ralf-e/HeishaMon/touch-extension/manufacturing/JLCPCB/Rev07/drill_report.txt

Drill report for HeishaMon_V6_Touch_Adapter.kicad_pcb
Created on 2026-10-30T16:30:36

Copper Layer Stackup:
    =============================================================
    L1 :  F.Cu                      front
    L2 :  B.Cu                      back

Drill file 'HeishaMon_V6_Touch_Adapter-PTH.drl' contains
    plated through holes:
    =============================================================
    T1  0.200mm  0.0079"  (79 holes))
    T2  0.700mm  0.0276"  (2 holes))
    T3  1.000mm  0.0394"  (20 holes))

    Total plated holes count 101

Drill file 'HeishaMon_V6_Touch_Adapter-NPTH.drl' contains
    unplated through holes:
    =============================================================

    Total unplated holes count 0
