ralf-e/HeishaMon/touch-extension/docs/adapter_spi.png

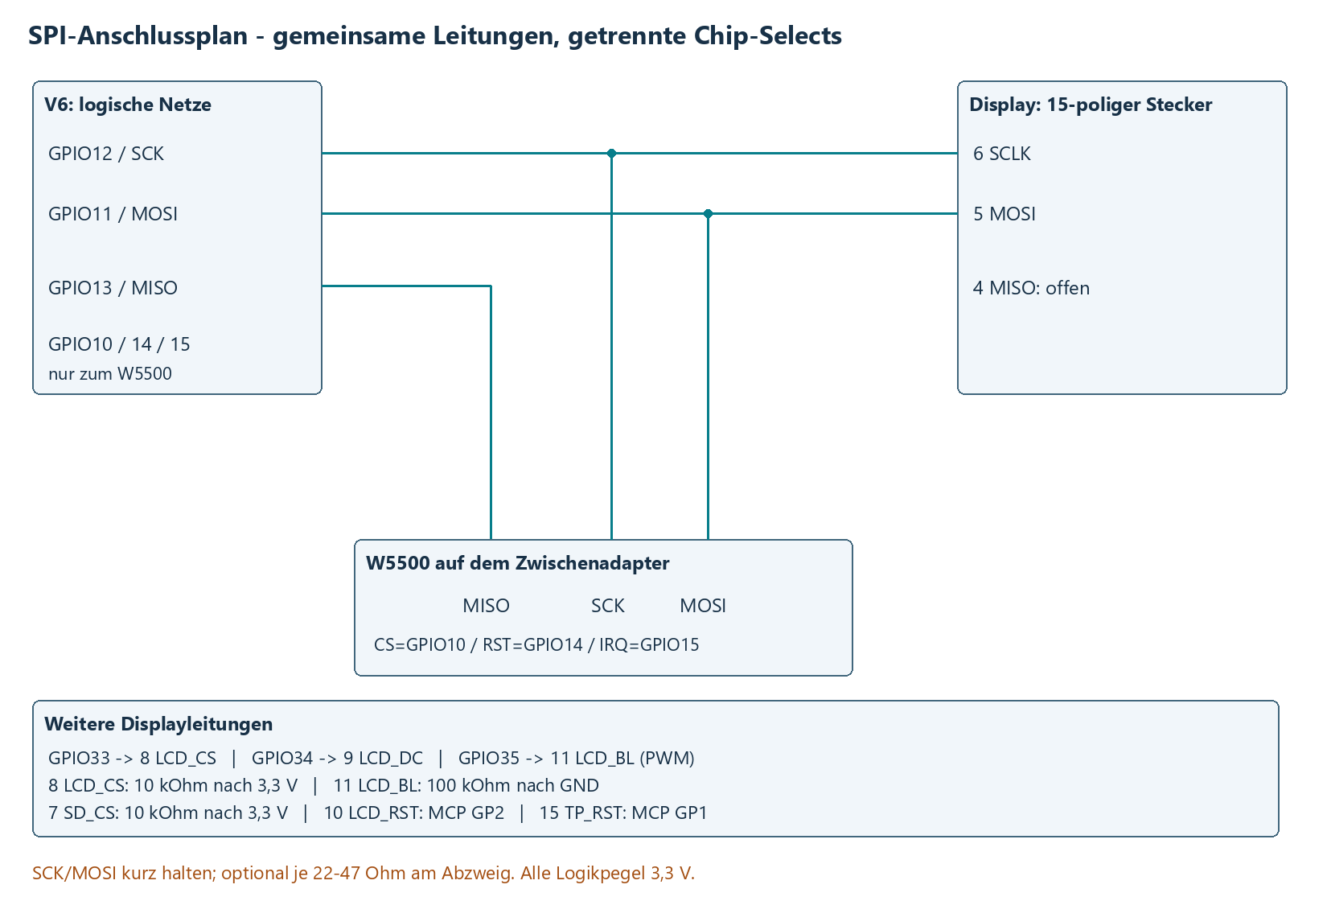
touch-extension/docs/adapter_spi.png
