ralf-e/HeishaMon/touch-extension/docs/display_topics.png

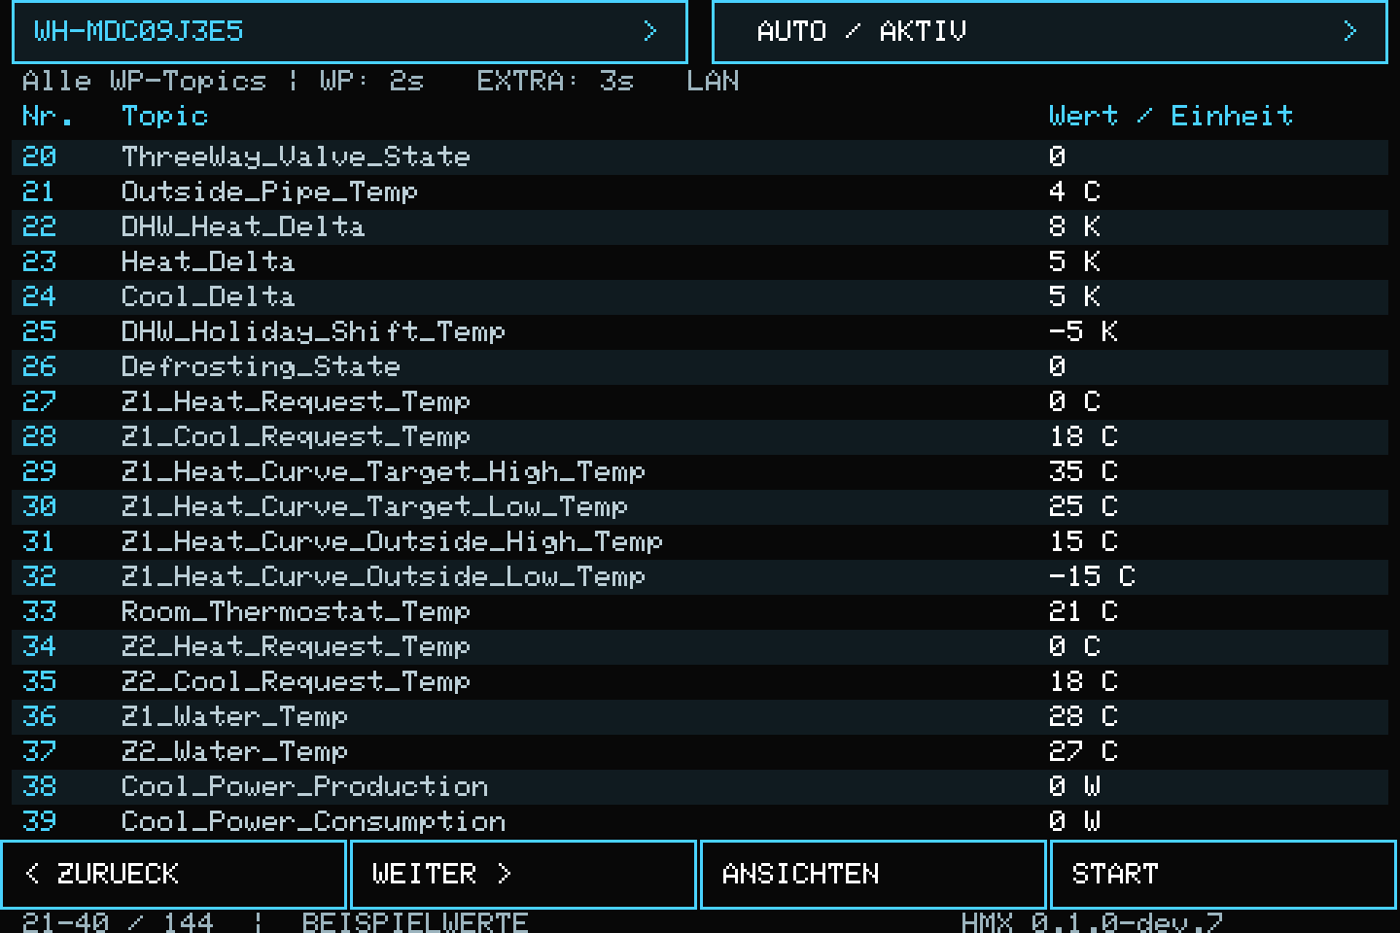
touch-extension/docs/display_topics.png
