ralf-e/HeishaMon/touch-extension/docs/PCB_Rueckseite.png

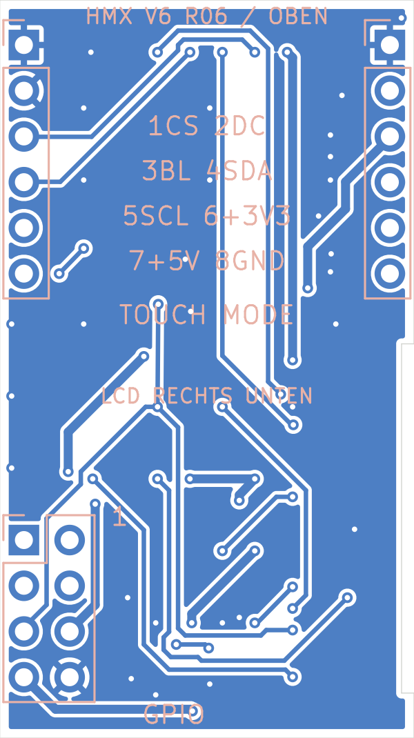
touch-extension/docs/PCB_Rueckseite.png
