ralf-e/HeishaMon/touch-extension/docs/PCB_Vorderseite.png

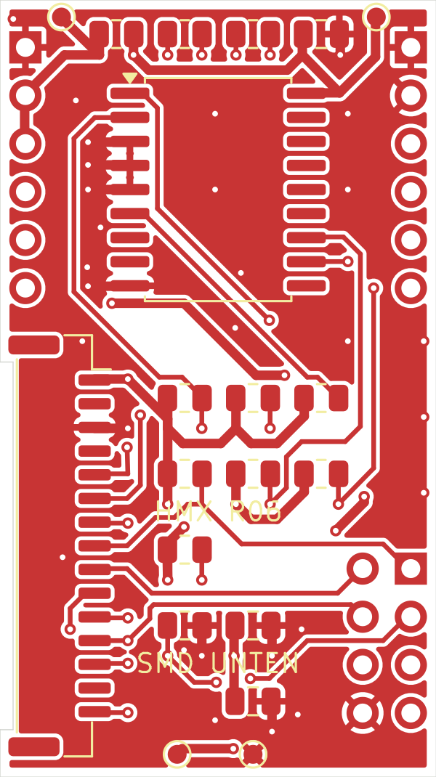
touch-extension/docs/PCB_Vorderseite.png
