ralf-e/HeishaMon/touch-extension/hardware/Rev07/Bestueckung_F.png

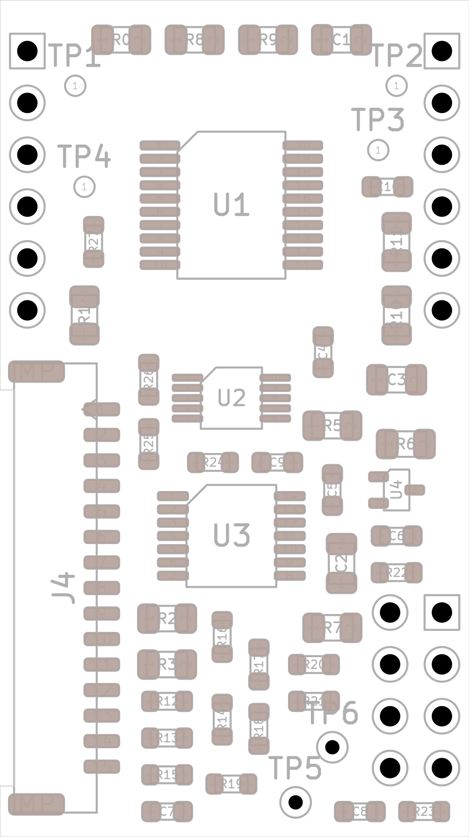
touch-extension/hardware/Rev07/Bestueckung_F.png
