ralf-e/HeishaMon/touch-extension/hardware/Rev07/Bestueckungsrotationen.png

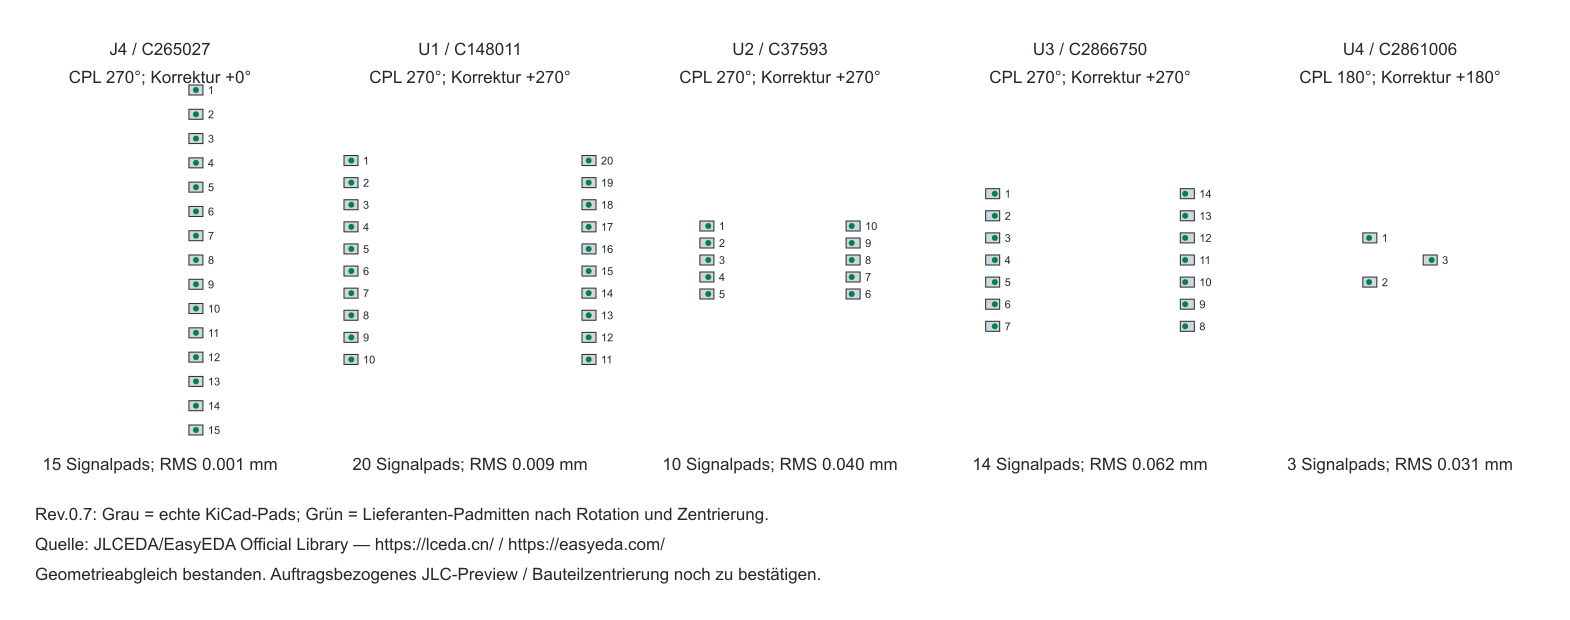
touch-extension/hardware/Rev07/Bestueckungsrotationen.png
