ralf-e/HeishaMon/touch-extension/hardware/Rev07/PCB_3D_Pruefansicht.png

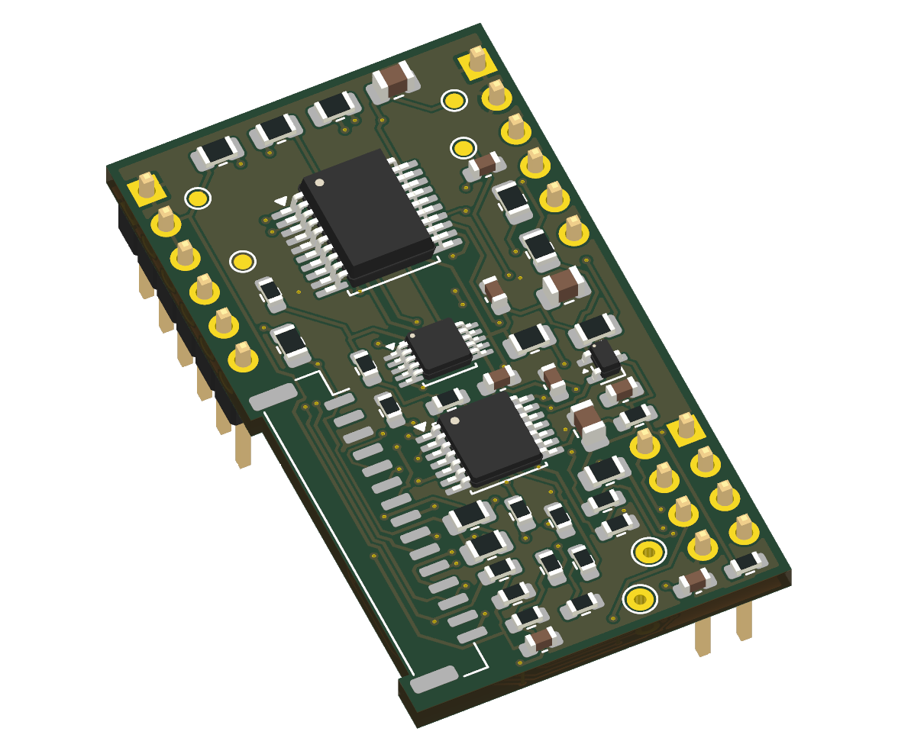
touch-extension/hardware/Rev07/PCB_3D_Pruefansicht.png
