ralf-e/HeishaMon/touch-extension/hardware/Rev07/PCB_Rueckseite.png

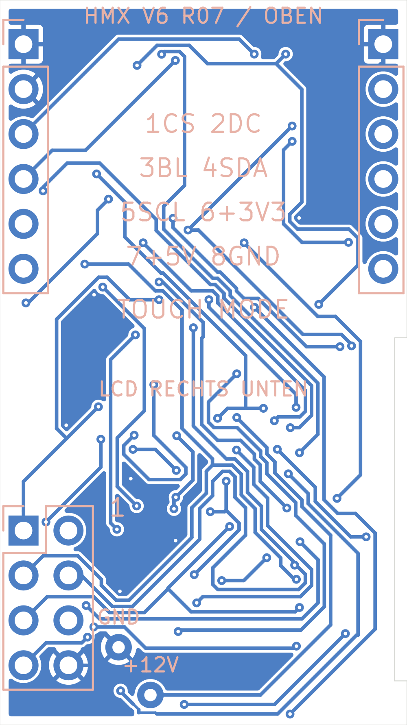
touch-extension/hardware/Rev07/PCB_Rueckseite.png
