ralf-e/HeishaMon/touch-extension/hardware/Rev07/PCB_Vorderseite.png

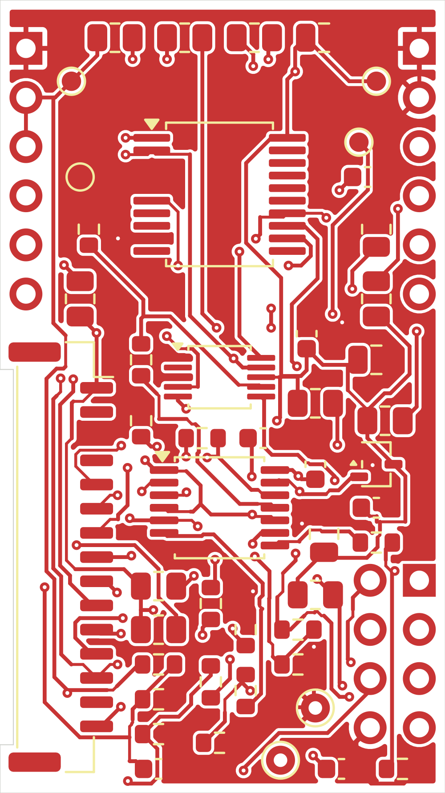
touch-extension/hardware/Rev07/PCB_Vorderseite.png
