ralf-e/HeishaMon/touch-extension/manufacturing/JLCPCB/Rev07/BOM_JLCPCB_REVIEW.csv

Comment | Designator | Footprint | LCSC Part #
0R | R0 | R_0805_2012Metric | C17477
4.7k 1% | R1,R2 | R_0805_2012Metric | C17673
10k 1% | R3,R5,R6,R7,R10 | R_0805_2012Metric | C17414
33R 1% | R8,R9 | R_0805_2012Metric | C17634
100k 1% | R11 | R_0805_2012Metric | C149504
100nF 50V X7R 10% | C1,C2 | C_0805_2012Metric | C49678
10uF 25V X5R 10% | C3 | C_0805_2012Metric | C15850
JST GH 15P 1.25mm Side Entry 90deg | J4 | JST_GH_SM15B-GHS-TB_1x15-1MP_P1.25mm_Horizontal | C265027
MCP23008 SSOP20 | U1 | SSOP-20_5.3x7.2mm_P0.65mm | C148011
ADS1115 VSSOP10 | U2 | TSSOP-10_3x3mm_P0.5mm | C37593
TMUX1511 TSSOP14 | U3 | TSSOP-14_4.4x5mm_P0.65mm | C2866750
2.93V supervisor SC70 | U4 | SOT-323_SC-70 | C2861006
10k 0.1% | R12,R13,R16,R17,R21,R25 | R_0603_1608Metric | C95204
20k 0.1% | R20 | R_0603_1608Metric | C723637
68k 0.1% | R24 | R_0603_1608Metric | C705793
1k 0.1% | R14,R18,R22,R26 | R_0603_1608Metric | C110776
100k 0.1% | R15,R19,R23,R27 | R_0603_1608Metric | C122538
100n X7R 50V 10% | C4,C5,C6,C7,C8,C9,C10 | C_0603_1608Metric | C1591
