ralf-e/HeishaMon/touch-extension/hardware/Rev07/V6_Kontaktpruefung.csv

Stecker | Pin | Sollnetz aus Entwurf | Referenz X montiert mm | Referenz Y montiert mm | Istnetz am V6 | Messwert/Abstand | Ergebnis
J1 | 1 | GND | 100.000 | 100.000 |  |  | OFFEN
J1 | 2 | GND | 100.000 | 102.540 |  |  | OFFEN
J1 | 3 | SPI_MOSI | 100.000 | 105.080 |  |  | OFFEN
J1 | 4 | SPI_SCK | 100.000 | 107.620 |  |  | OFFEN
J1 | 5 | ETH_CS | 100.000 | 110.160 |  |  | OFFEN
J1 | 6 | ETH_IRQ | 100.000 | 112.700 |  |  | OFFEN
J2 | 1 | GND | 120.320 | 100.000 |  |  | OFFEN
J2 | 2 | +3V3_V6 | 120.320 | 102.540 |  |  | OFFEN
J2 | 3 | +3V3_V6 | 120.320 | 105.080 |  |  | OFFEN
J2 | 4 | NC | 120.320 | 107.620 |  |  | OFFEN
J2 | 5 | ETH_RST | 120.320 | 110.160 |  |  | OFFEN
J2 | 6 | SPI_MISO | 120.320 | 112.700 |  |  | OFFEN
J3 | 1 | LCD_CS | 100.000 | 127.500 |  |  | OFFEN
J3 | 2 | LCD_DC | 102.540 | 127.500 |  |  | OFFEN
J3 | 3 | LCD_BL | 100.000 | 130.040 |  |  | OFFEN
J3 | 4 | I2C_SDA | 102.540 | 130.040 |  |  | OFFEN
J3 | 5 | I2C_SCL | 100.000 | 132.580 |  |  | OFFEN
J3 | 6 | +3V3_V6 | 102.540 | 132.580 |  |  | OFFEN
J3 | 7 | +5V_V6 | 100.000 | 135.120 |  |  | OFFEN
J3 | 8 | GND | 102.540 | 135.120 |  |  | OFFEN
