ralf-e/HeishaMon/touch-extension/hardware/Rev07/Gesamtschaltplan_rev07.pdf

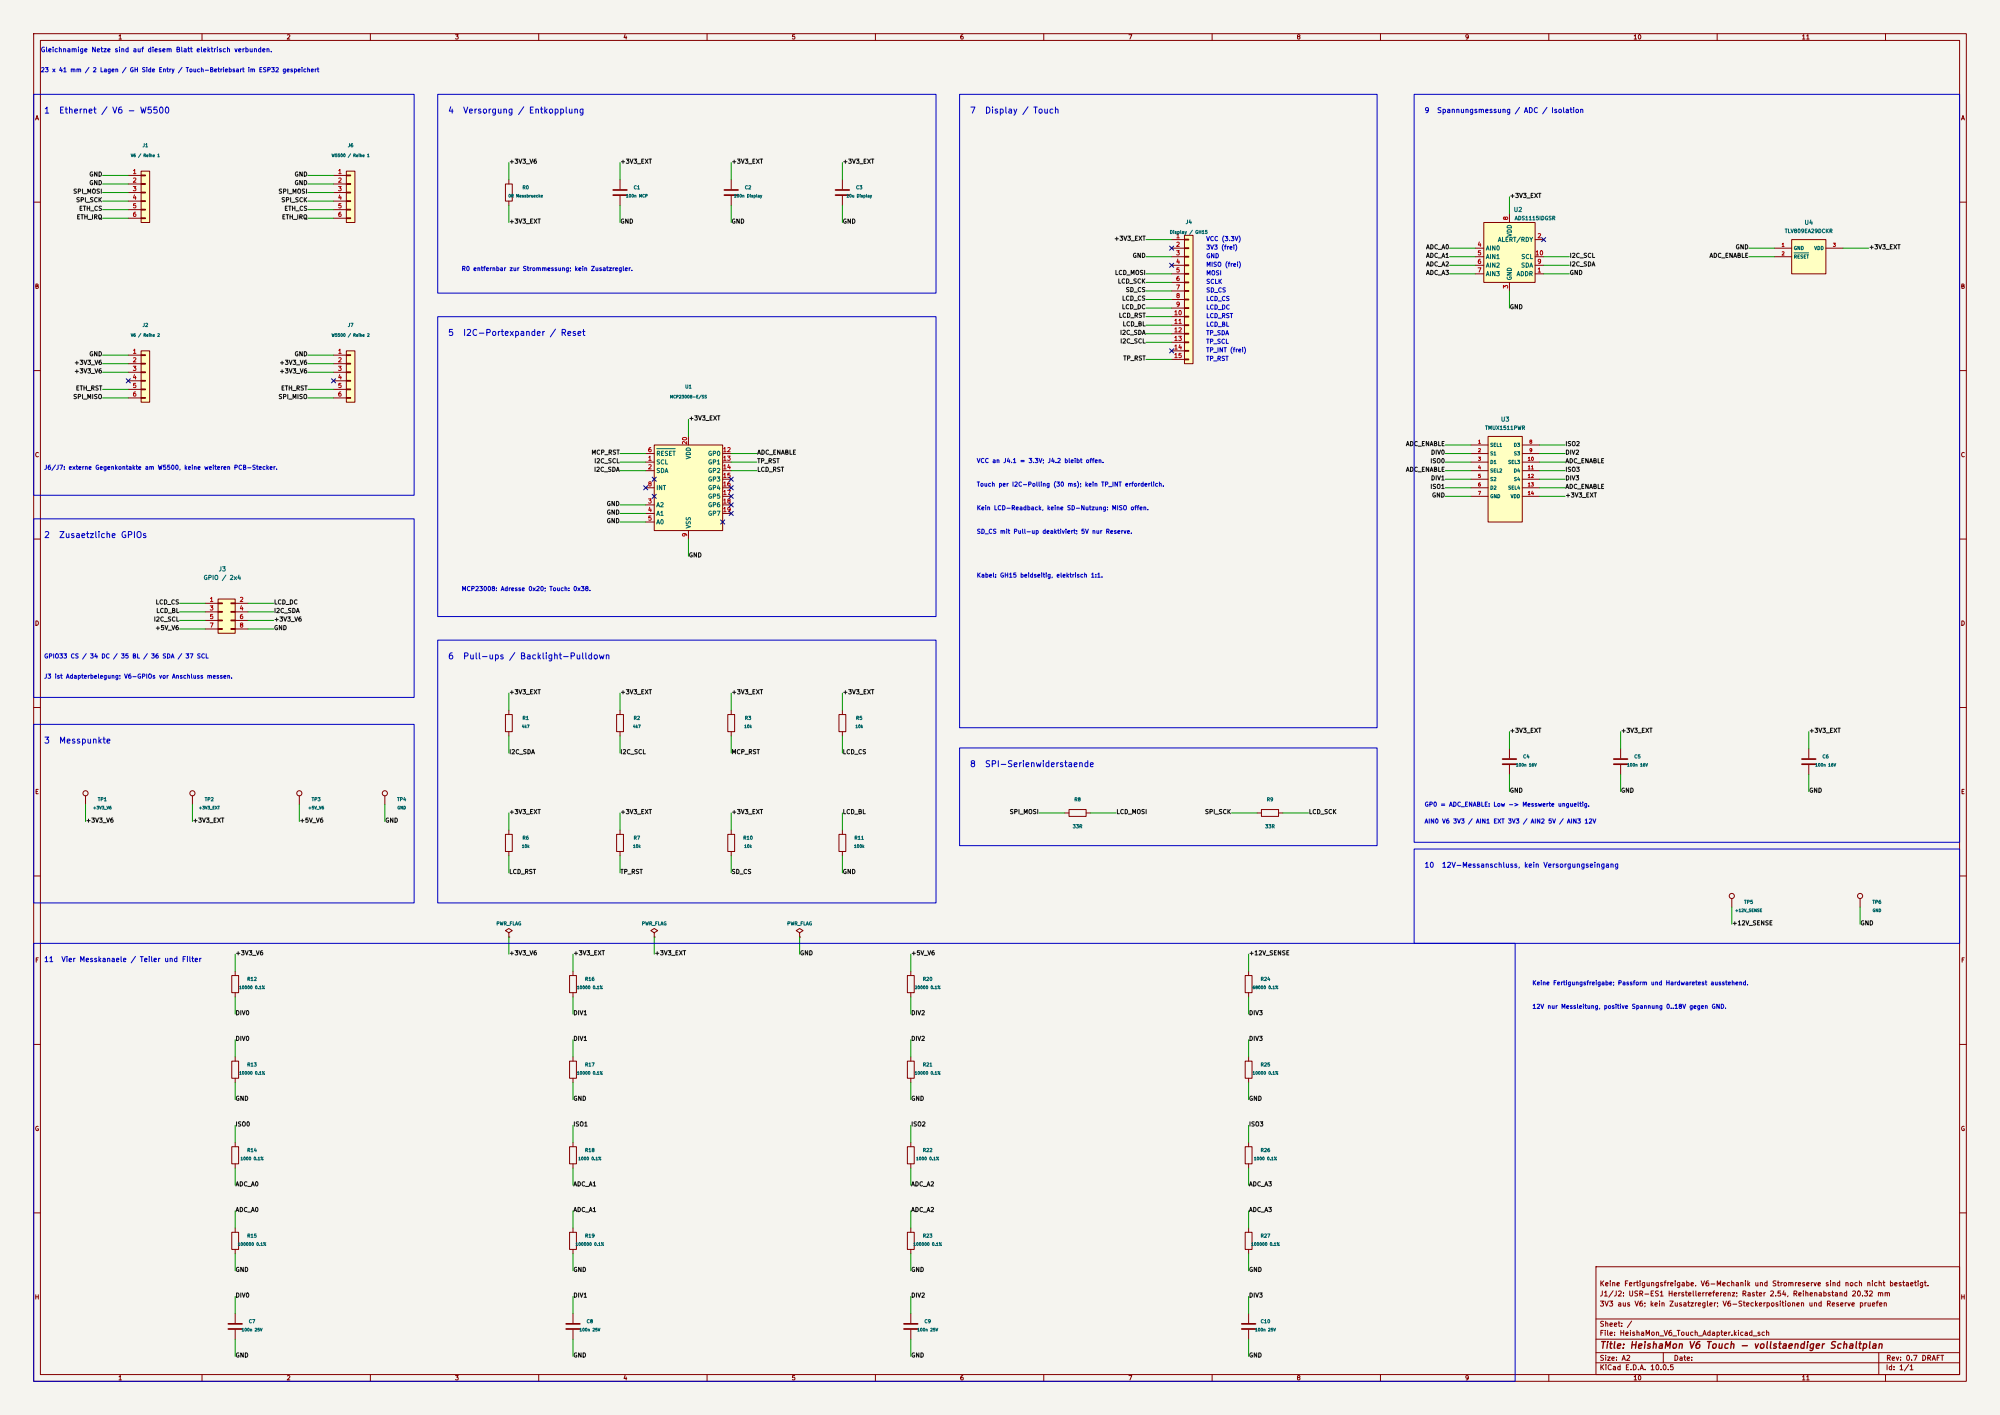
[picture p26: page 1]

Gleichnamige Netze sind auf diesem Blatt elektrisch verbunden.

23 x 41 mm / 2 Lagen / GH Side Entry / Touch-Betriebsart im ESP32 gespeichert

VCC (3.3V) Kabel: GH15 beidseitig, elektrisch 1:1.

MISO (frei) Touch per I2C-Polling (30 ms); kein TP_INT erforderlich. 6 Pull-ups / Backlight-Pulldown
R0 entfernbar zur Strommessung; kein Zusatzregler.

GPIO33 CS / 34 DC / 35 BL / 36 SDA / 37 SCL

GP0 = ADC_ENABLE: Low -> Messwerte ungueltig. AIN0 V6 3V3 / AIN1 EXT 3V3 / AIN2 5V / AIN3 12V Keine Fertigungsfreigabe; Passform und Hardwaretest ausstehend. 12V nur Messleitung, positive Spannung 0..18V gegen GND.

11 Vier Messkanaele / Teiler und Filter
FGH

Keine Fertigungsfreigabe. V6-Mechanik und Stromreserve sind noch nicht bestaetigt. R15

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

Sheet: /
File: HeishaMon_V6_Touch_Adapter.kicad_sch
Title: HeishaMon V6 Touch - vollstaendiger Schaltplan

Size: A2 | Rev: 0.7 DRAFT
KiCad E.D.A. 10.0.5 | Id: 1/1
