ralf-e/HeishaMon/(list of files, drawings)

Other design files:
touch-extension/hardware/pcb_audit.json
touch-extension/hardware/pcb_geometry.json
