ralf-e/HeishaMon/touch-extension/hardware/Rev07/HeishaMon_V6_Touch_Adapter.kicad_pcb

## KiCad design touch-extension/hardware/Rev07/HeishaMon_V6_Touch_Adapter.kicad_pcb (2026-10-30)

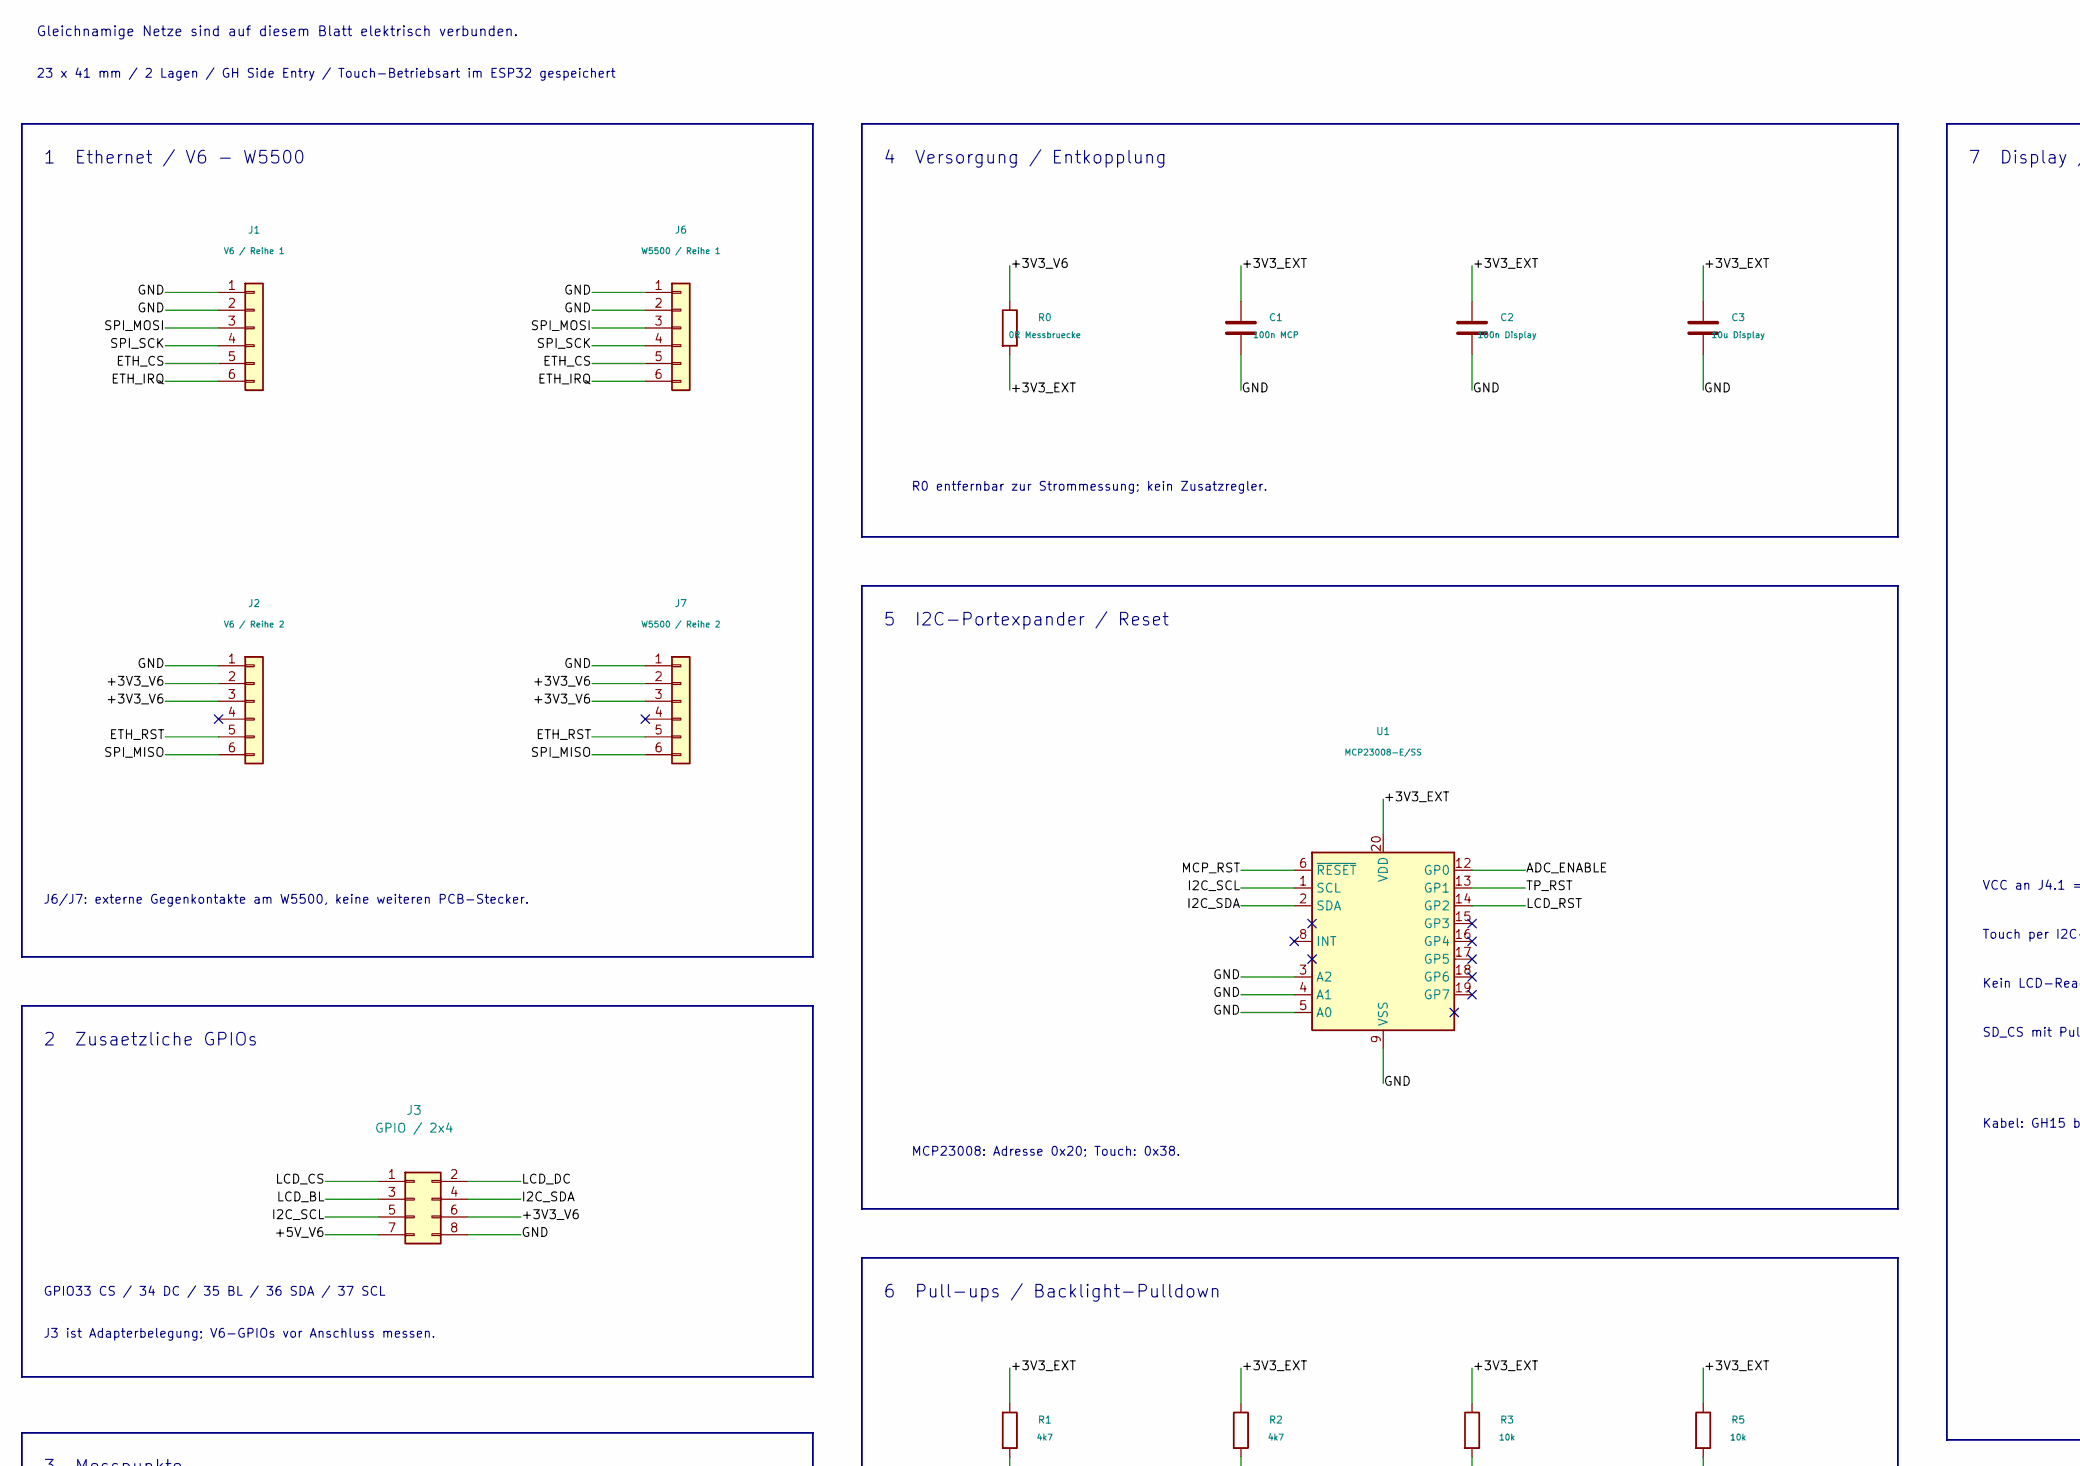
[picture p27: schematic HeishaMon_V6_Touch_Adapter.kicad_sch, HeishaMon V6 Touch - vollstaendiger Schaltplan, part in row 1, column 1]

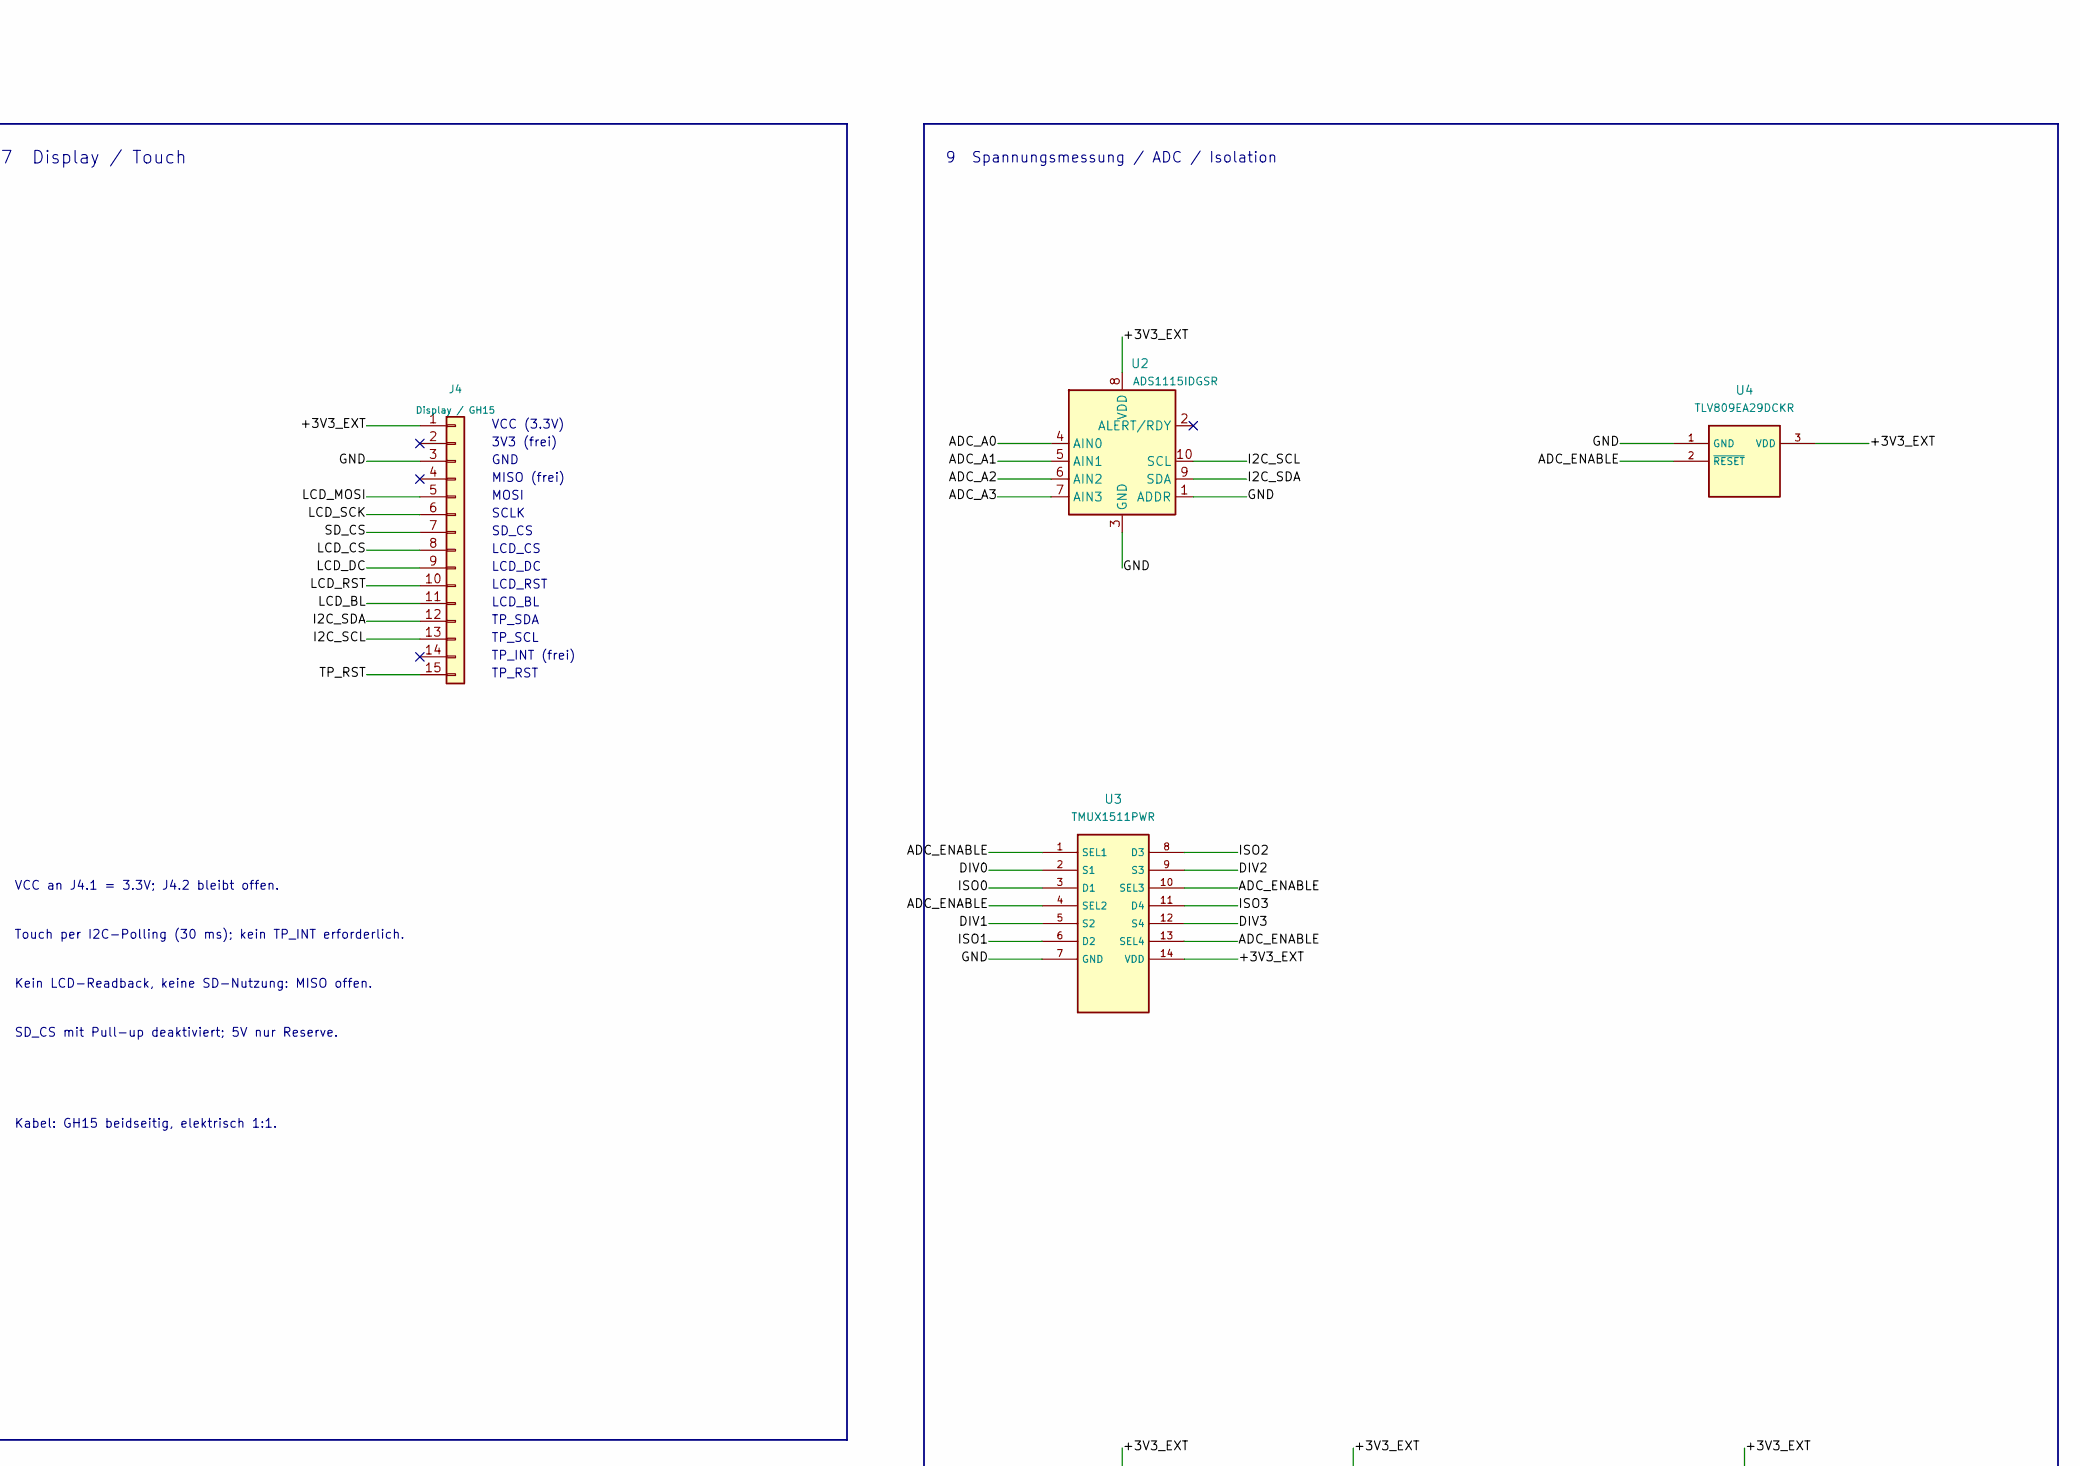
[picture p28: schematic HeishaMon_V6_Touch_Adapter.kicad_sch, HeishaMon V6 Touch - vollstaendiger Schaltplan, part in row 1, column 2]

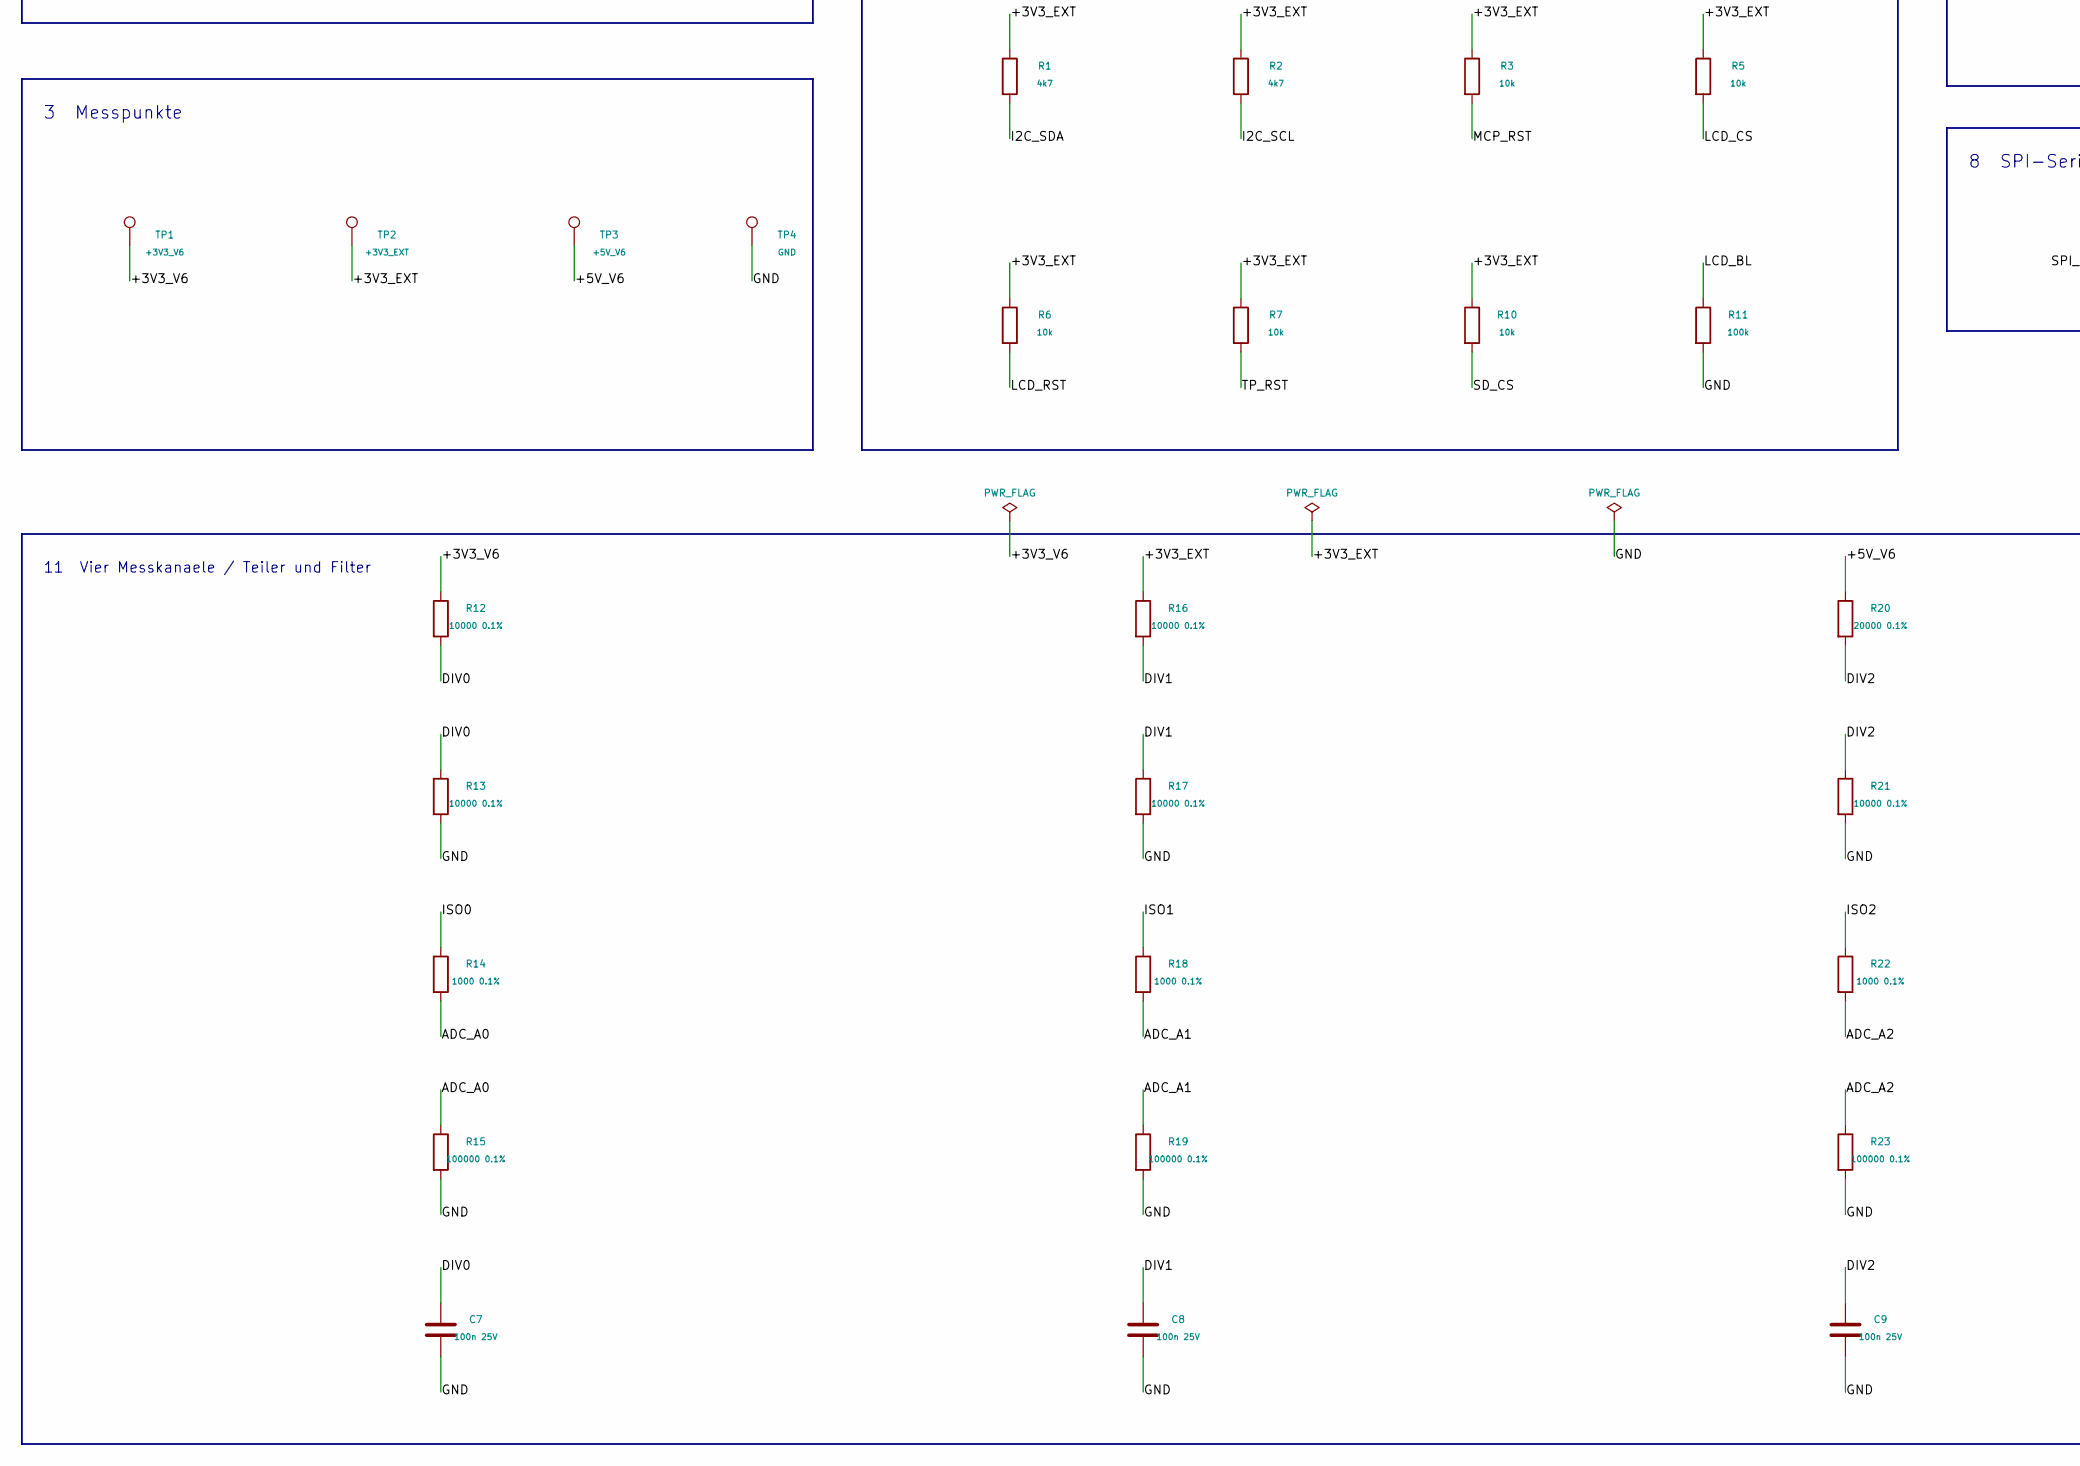
[picture p29: schematic HeishaMon_V6_Touch_Adapter.kicad_sch, HeishaMon V6 Touch - vollstaendiger Schaltplan, part in row 2, column 1]

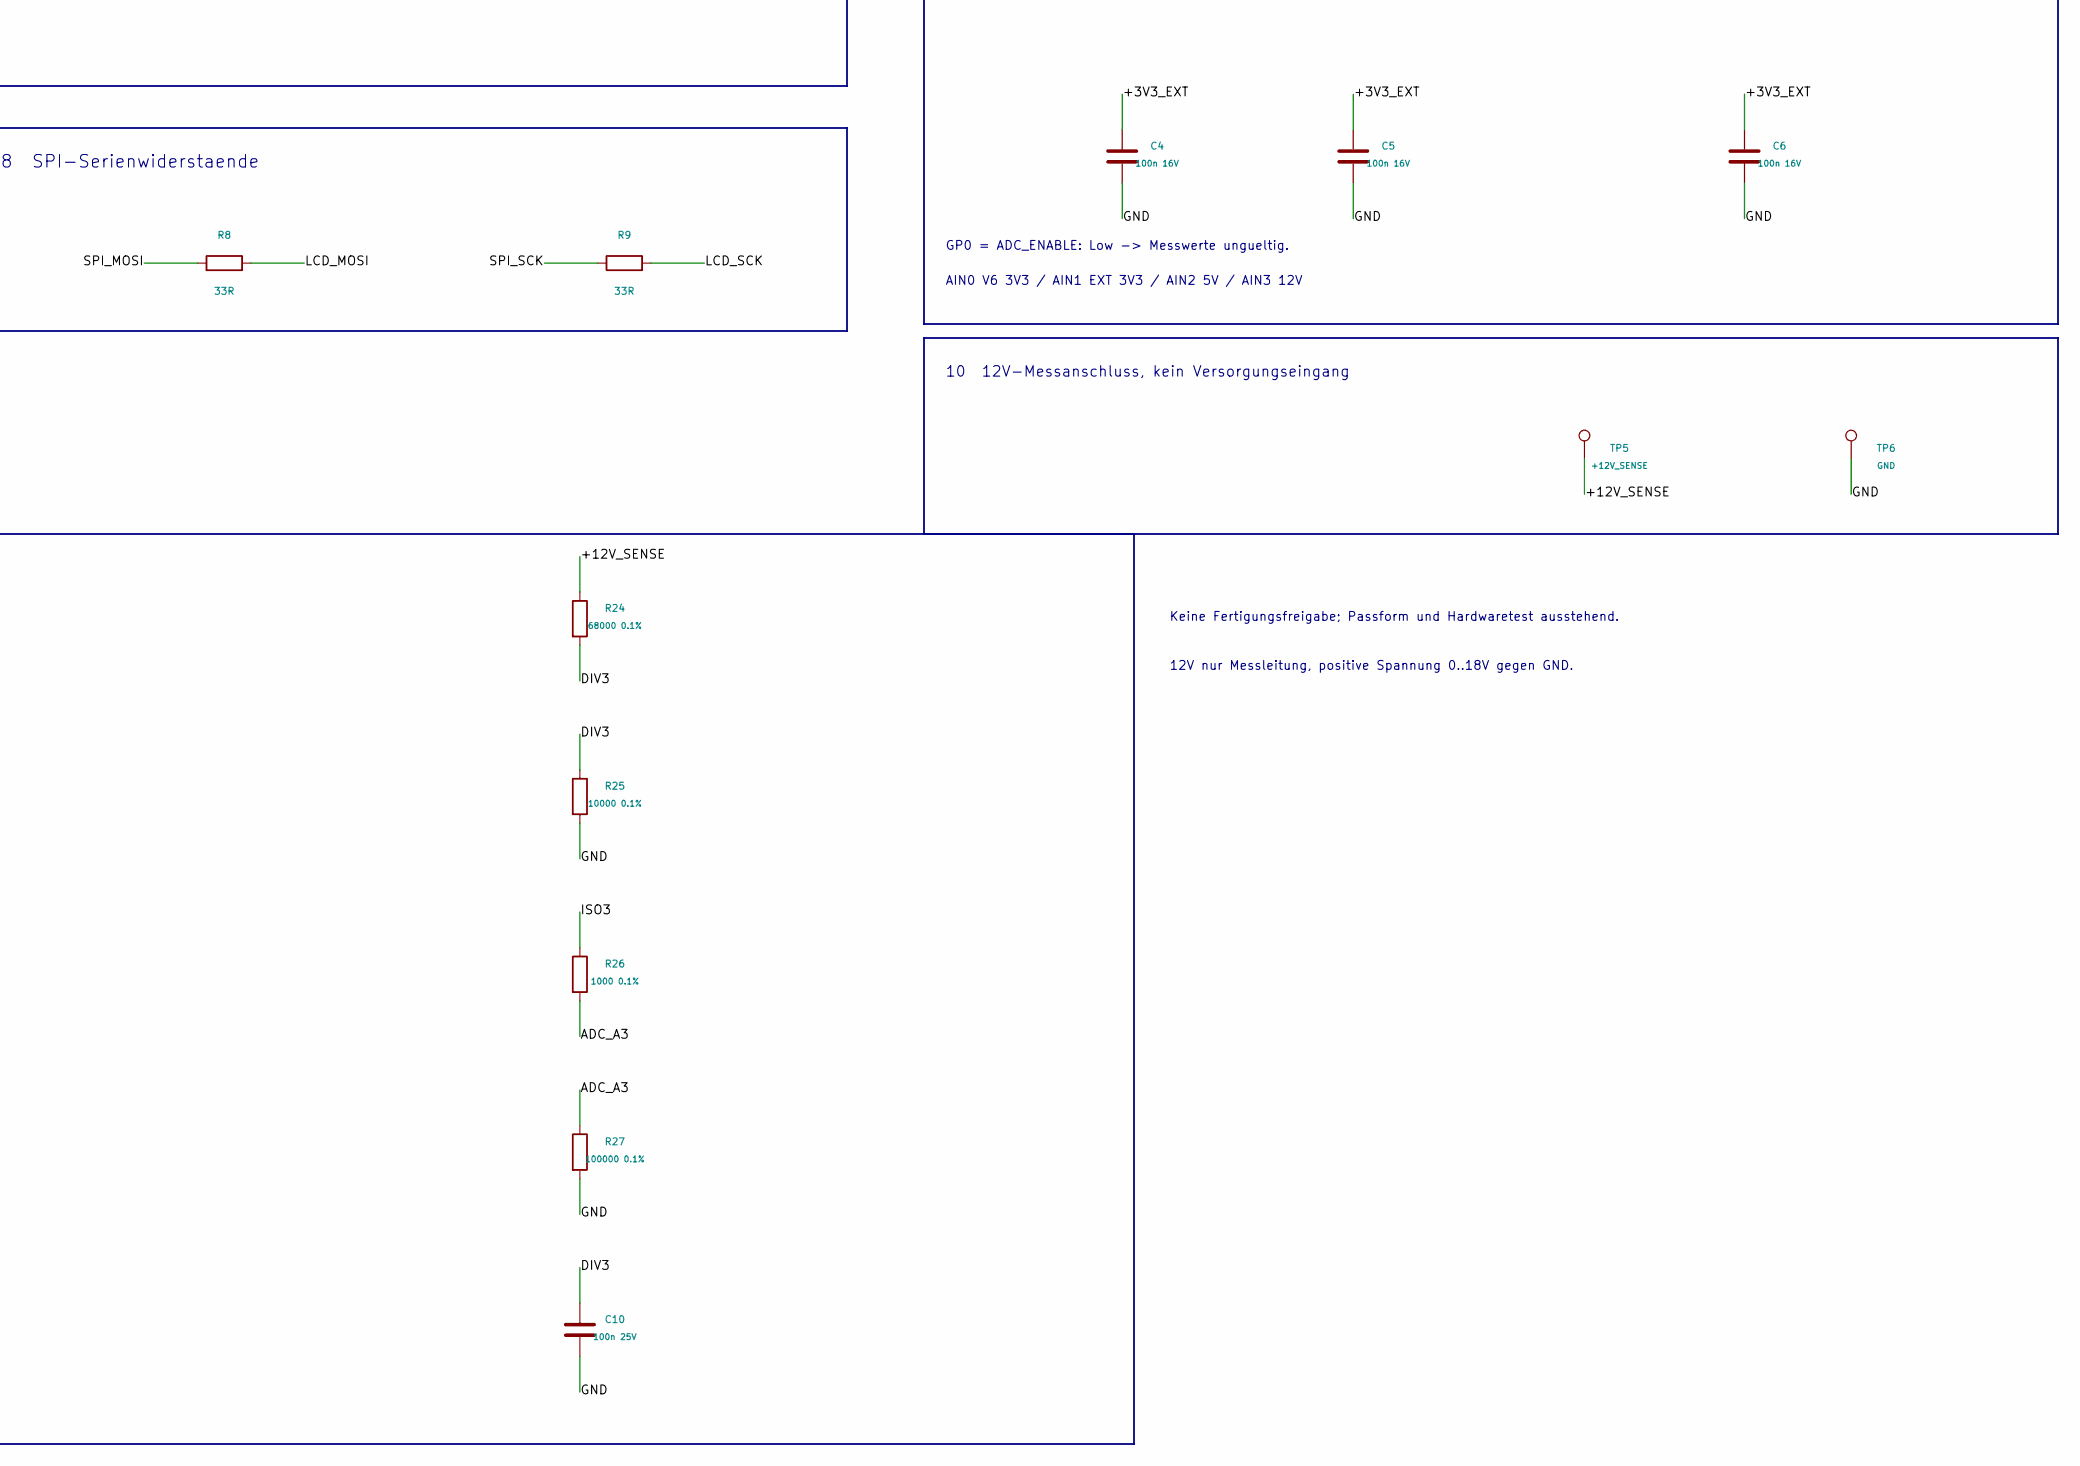
[picture p30: schematic HeishaMon_V6_Touch_Adapter.kicad_sch, HeishaMon V6 Touch - vollstaendiger Schaltplan, part in row 2, column 2]

Parts:
C1: 100n MCP; C_0805_2012Metric
C2: 100n Display; C_0805_2012Metric
C3: 10u Display; C_0805_2012Metric
C4, C5, C6: 100n 16V; C_0603_1608Metric
C7, C8, C9, C10: 100n 25V; C_0603_1608Metric
J1: V6 / Reihe 1; PinHeader_1x06_P2.54mm_Vertical
J2: V6 / Reihe 2; PinHeader_1x06_P2.54mm_Vertical
J3: GPIO / 2x4; PinHeader_2x04_P2.54mm_Vertical
J4: Display / GH15; JST_GH_SM15B-GHS-TB_1x15-1MP_P1.25mm_Horizontal
J6: W5500 / Reihe 1
J7: W5500 / Reihe 2
R0: 0R Messbruecke; R_0805_2012Metric
R1, R2: 4k7; R_0805_2012Metric
R3, R5, R6, R7, R10: 10k; R_0805_2012Metric
R8, R9: 33R; R_0805_2012Metric
R11: 100k; R_0805_2012Metric
R12, R13, R16, R17, R21, R25: 10000 0.1%; R_0603_1608Metric
R14, R18, R22, R26: 1000 0.1%; R_0603_1608Metric
R15, R19, R23, R27: 100000 0.1%; R_0603_1608Metric
R20: 20000 0.1%; R_0603_1608Metric
R24: 68000 0.1%; R_0603_1608Metric
TP1: +3V3_V6; TestPoint_Pad_D1.0mm
TP2: +3V3_EXT; TestPoint_Pad_D1.0mm
TP3: +5V_V6; TestPoint_Pad_D1.0mm
TP4: GND; TestPoint_Pad_D1.0mm
TP5: +12V_SENSE; TestPoint_THTPad_D1.5mm_Drill0.7mm
TP6: GND; TestPoint_THTPad_D1.5mm_Drill0.7mm
U1: MCP23008-E/SS; SSOP-20_5.3x7.2mm_P0.65mm
U2: ADS1115IDGSR; TSSOP-10_3x3mm_P0.5mm
U3: TMUX1511PWR; TSSOP-14_4.4x5mm_P0.65mm
U4: TLV809EA29DCKR; SOT-323_SC-70

Connections:
+3V3_EXT: C1.1, C2.1, C3.1, C4.1, C5.1, C6.1, J4.1, R0.2, R1.1, R2.1, R3.1, R5.1, R6.1, R7.1, R10.1, R16.1, TP2.1, U1.20 (VDD), U2.8 (VDD), U3.14 (VDD), U4.3 (VDD)
+3V3_V6: J2.2, J2.3, J3.6, J7.2, J7.3, R0.1, R12.1, TP1.1
+5V_V6: J3.7, R20.1, TP3.1
+12V_SENSE: R24.1, TP5.1
ADC_A0: R14.2, R15.1, U2.4 (AIN0)
ADC_A1: R18.2, R19.1, U2.5 (AIN1)
ADC_A2: R22.2, R23.1, U2.6 (AIN2)
ADC_A3: R26.2, R27.1, U2.7 (AIN3)
ADC_ENABLE: U1.12 (GP0), U3.1 (SEL1), U3.4 (SEL2), U3.10 (SEL3), U3.13 (SEL4), U4.2 (~RESET)
DIV0: C7.1, R12.2, R13.1, U3.2 (S1)
DIV1: C8.1, R16.2, R17.1, U3.5 (S2)
DIV2: C9.1, R20.2, R21.1, U3.9 (S3)
DIV3: C10.1, R24.2, R25.1, U3.12 (S4)
ETH_CS: J1.5, J6.5
ETH_IRQ: J1.6, J6.6
ETH_RST: J2.5, J7.5
GND: C1.2, C2.2, C3.2, C4.2, C5.2, C6.2, C7.2, C8.2, C9.2, C10.2, J1.1, J1.2, J2.1, J3.8, J4.3, J6.1, J6.2, J7.1, R11.2, R13.2, R15.2, R17.2, R19.2, R21.2, R23.2, R25.2, R27.2, TP4.1, TP6.1, U1.3 (A2), U1.4 (A1), U1.5 (A0), U1.9 (VSS), U2.1 (ADDR), U2.3 (GND), U3.7 (GND), U4.1 (GND)
I2C_SCL: J3.5, J4.13, R2.2, U1.1 (SCL), U2.10 (SCL)
I2C_SDA: J3.4, J4.12, R1.2, U1.2 (SDA), U2.9 (SDA)
ISO0: R14.1, U3.3 (D1)
ISO1: R18.1, U3.6 (D2)
ISO2: R22.1, U3.8 (D3)
ISO3: R26.1, U3.11 (D4)
LCD_BL: J3.3, J4.11, R11.1
LCD_CS: J3.1, J4.8, R5.2
LCD_DC: J3.2, J4.9
LCD_MOSI: J4.5, R8.2
LCD_RST: J4.10, R6.2, U1.14 (GP2)
LCD_SCK: J4.6, R9.2
MCP_RST: R3.2, U1.6 (~RESET)
SD_CS: J4.7, R10.2
SPI_MISO: J2.6, J7.6
SPI_MOSI: J1.3, J6.3, R8.1
SPI_SCK: J1.4, J6.4, R9.1
TP_RST: J4.15, R7.2, U1.13 (GP1)

Notes on the sheet:
1 Ethernet / V6 - W5500
2 Zusaetzliche GPIOs
3 Messpunkte
4 Versorgung / Entkopplung
5 I2C-Portexpander / Reset
6 Pull-ups / Backlight-Pulldown
7 Display / Touch
8 SPI-Serienwiderstaende
VCC (3.3V)
3V3 (frei)
GND
MISO (frei)
MOSI
SCLK
SD_CS
LCD_CS
LCD_DC
LCD_RST
LCD_BL
TP_SDA
TP_SCL
TP_INT (frei)
TP_RST
Gleichnamige Netze sind auf diesem Blatt elektrisch verbunden.
23 x 41 mm / 2 Lagen / GH Side Entry / Touch-Betriebsart im ESP32 gespeichert
J6/J7: externe Gegenkontakte am W5500, keine weiteren PCB-Stecker.
J3 ist Adapterbelegung; V6-GPIOs vor Anschluss messen.
GPIO33 CS / 34 DC / 35 BL / 36 SDA / 37 SCL
VCC an J4.1 = 3.3V; J4.2 bleibt offen.
Touch per I2C-Polling (30 ms); kein TP_INT erforderlich.
Kein LCD-Readback, keine SD-Nutzung: MISO offen.
SD_CS mit Pull-up deaktiviert; 5V nur Reserve.
Kabel: GH15 beidseitig, elektrisch 1:1.
MCP23008: Adresse 0x20; Touch: 0x38.
R0 entfernbar zur Strommessung; kein Zusatzregler.
9 Spannungsmessung / ADC / Isolation
10 12V-Messanschluss, kein Versorgungseingang
11 Vier Messkanaele / Teiler und Filter
GP0 = ADC_ENABLE: Low -> Messwerte ungueltig.
AIN0 V6 3V3 / AIN1 EXT 3V3 / AIN2 5V / AIN3 12V
Keine Fertigungsfreigabe; Passform und Hardwaretest ausstehend.
12V nur Messleitung, positive Spannung 0..18V gegen GND.

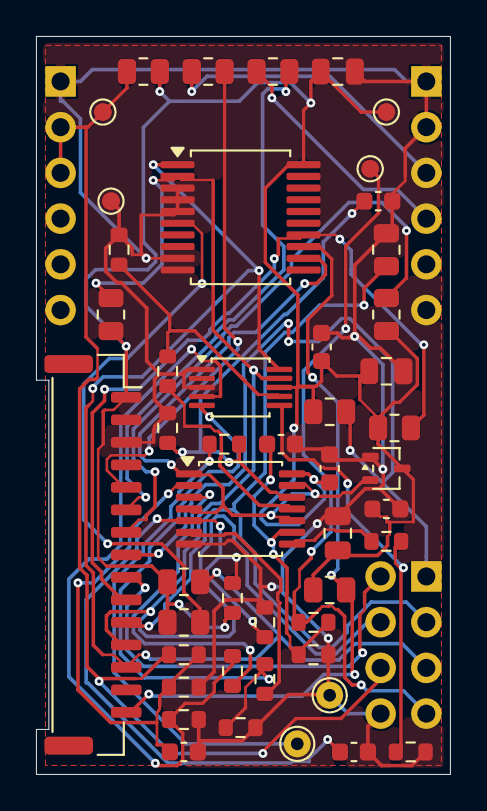
[picture p31: board HeishaMon_V6_Touch_Adapter.kicad_pcb from above]

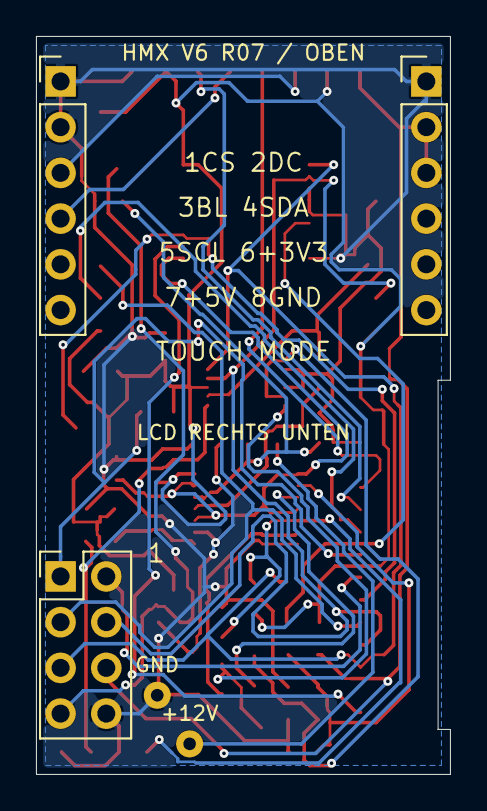
[picture p32: board HeishaMon_V6_Touch_Adapter.kicad_pcb from below]

Board: 2 copper layers, 23.0 x 41.0 mm, 51 parts (3 on the bottom side), 31 nets.
