ralf-e/HeishaMon/(commit log)

2026-10-26 Add isolated ESP32-S3 touch display extension and build workflow
    [Alternatives.csv, Availability_2026-10-25.csv, BOM_Detail.csv, BOM_JLCPCB.csv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]
2026-10-30 Add compact Rev07 voltage-monitor adapter and reviewed manufacturing docs
    [BOM_Detail.csv, BOM_JLCPCB_REVIEW.csv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]
